norioike/M5StickC_Vibrator_Hat/ModelingData/ModelingImage.png

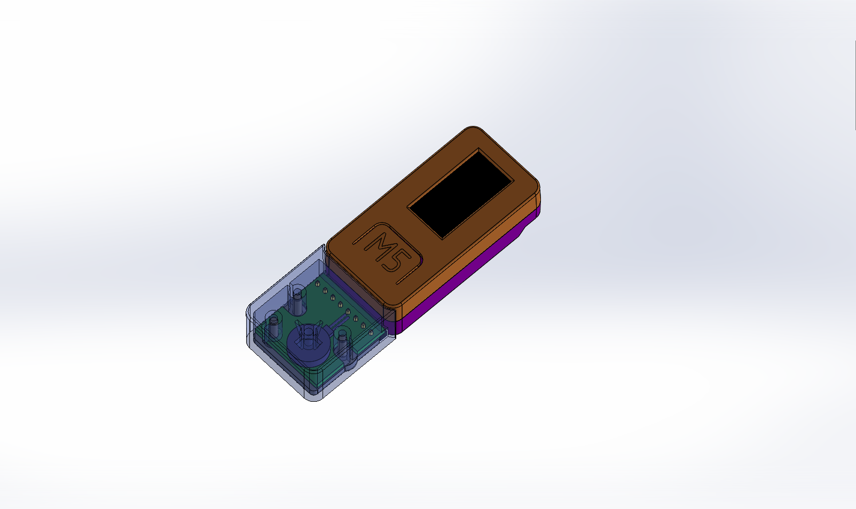
ModelingData/ModelingImage.png
