norioike/M5StickC_Vibrator_Hat/Schematic/hatBoard.pdf

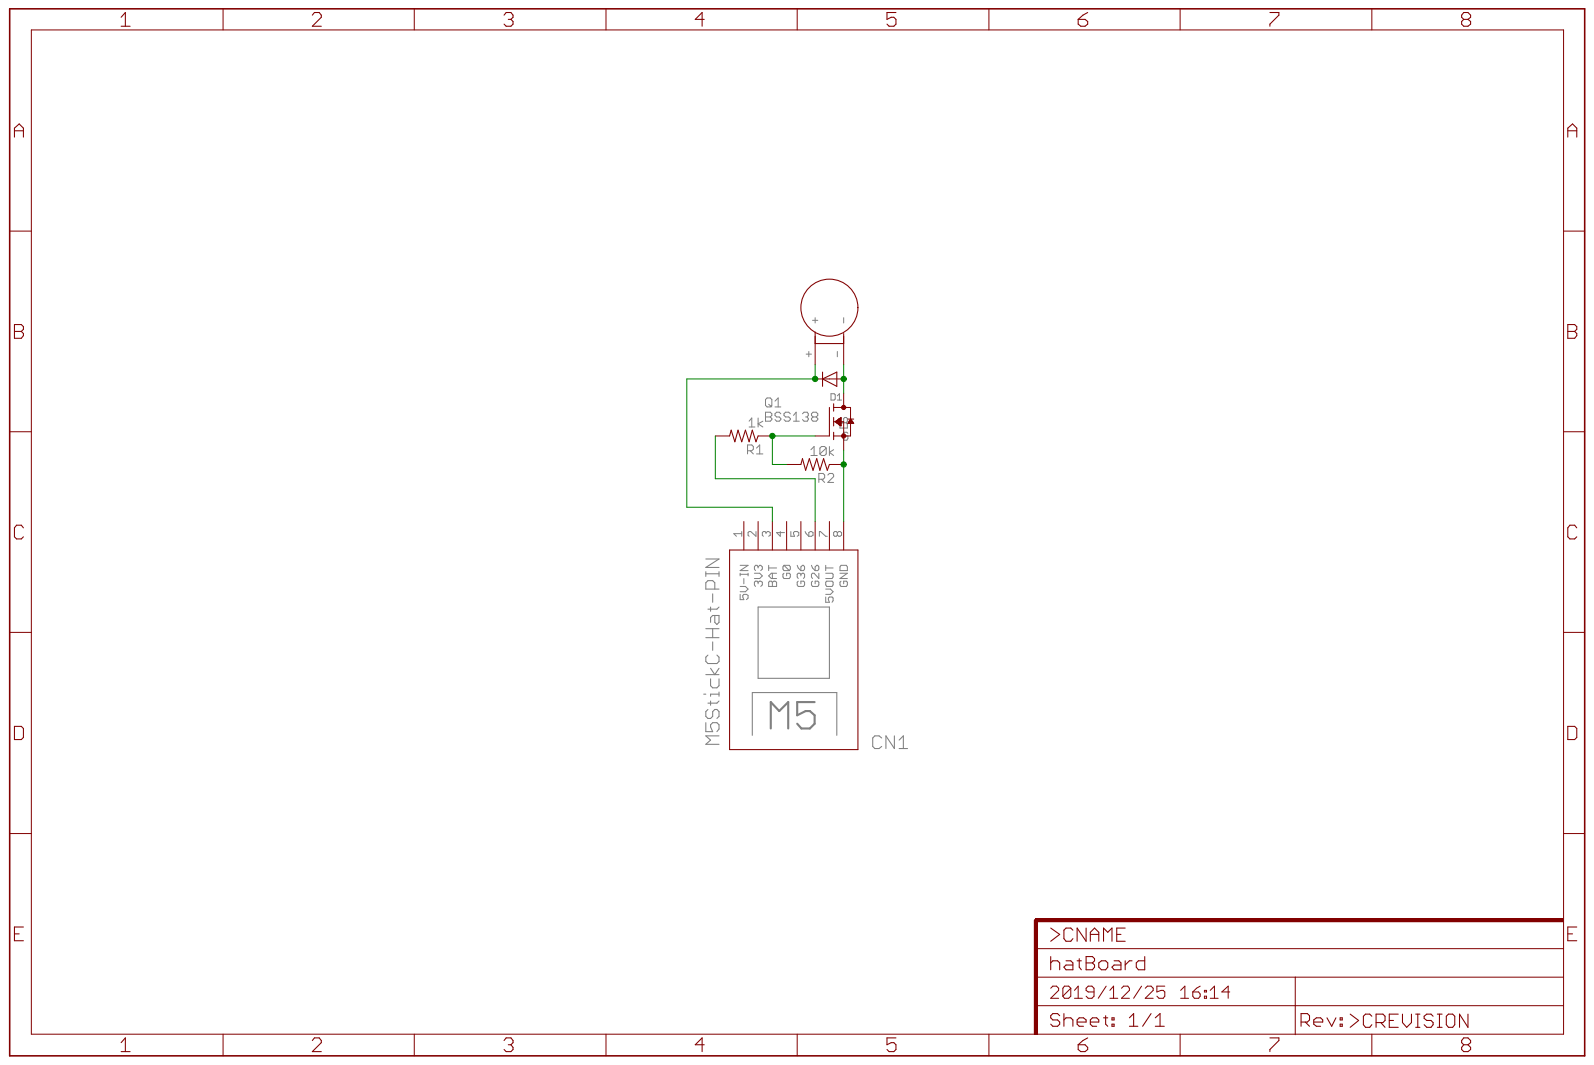
[picture p3: page 1]
