norioike/M5StickC_Vibrator_Hat/(commit log)

2019-12-25 issue datas
    [ModelingData.STEP]
2019-12-25 update sample code
2020-01-15 add New sample
